Wierus/CountryClock/Data/Photo/WorkMode - ShowTemperature - No sensor.JPG

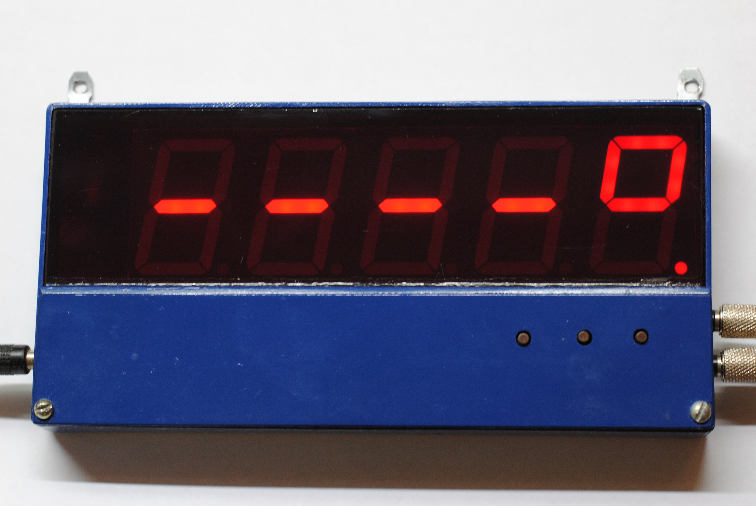
Data/Photo/WorkMode - ShowTemperature - No sensor.JPG
