Wierus/CountryClock/Data/Photo/WorkMode - ShowTime.JPG

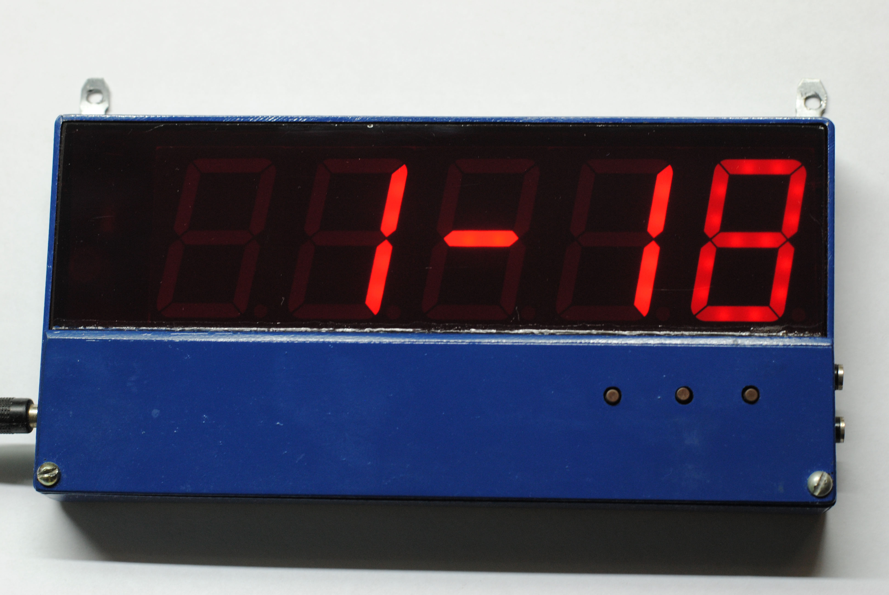
Data/Photo/WorkMode - ShowTime.JPG
