Wierus/CountryClock/Data/Tasks.pdf

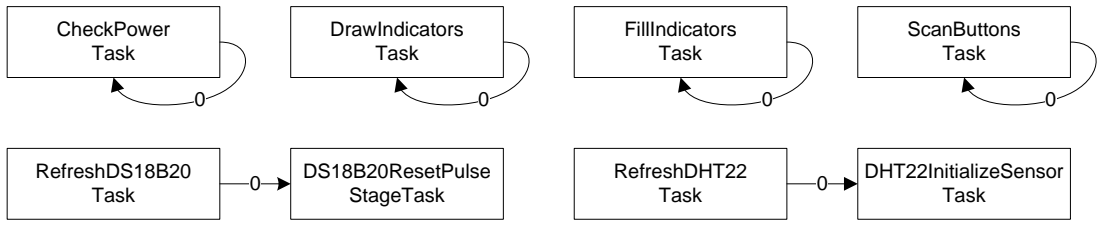
[picture p3: figure]
ScanButtons Task; DrawIndicators Task; FillIndicators Task; RefreshDHT22 Task; CheckPower Task; DS18B20ResetPulse StageTask; RefreshDS18B20; Task; DHT22InitializeSensor Task
