Wierus/CountryClock/Data/Photo/PCB Front.JPG

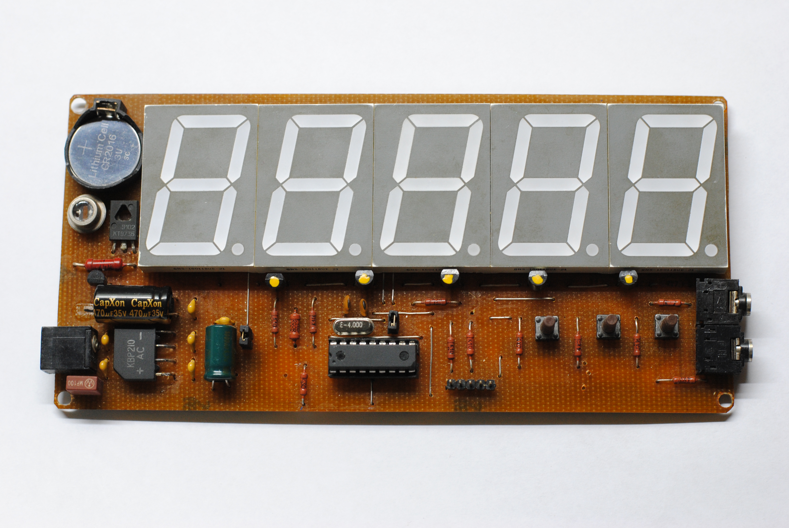
Data/Photo/PCB Front.JPG
