Wierus/CountryClock/Data/Photo/WorkMode - ShowHumidity.JPG

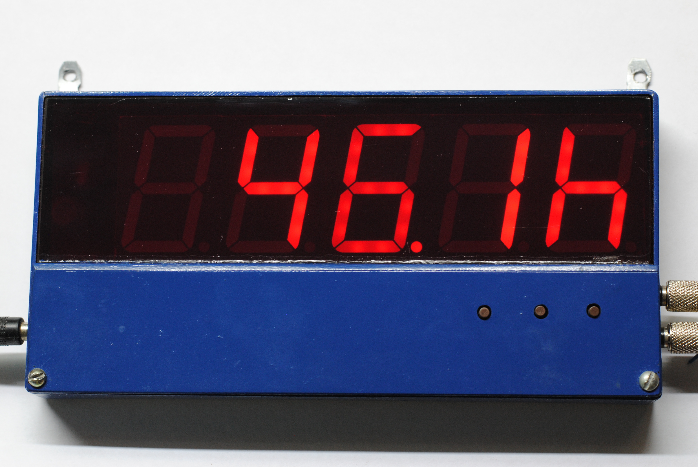
Data/Photo/WorkMode - ShowHumidity.JPG
