Wierus/CountryClock/Data/Photo/WorkMode - ShowTemperature.JPG

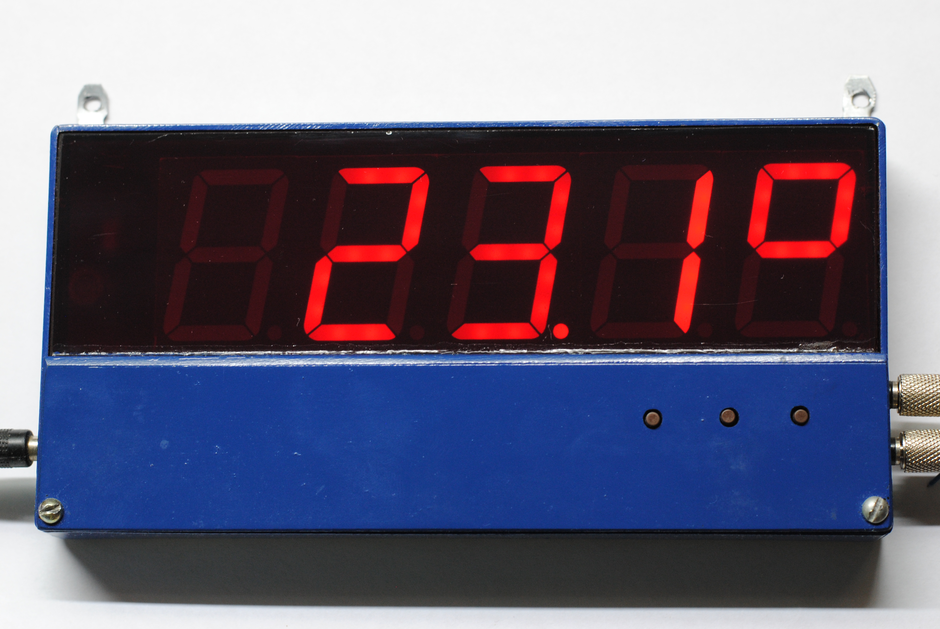
Data/Photo/WorkMode - ShowTemperature.JPG
