Wierus/CountryClock/Scheme/CountryClock (Build).PDF

## USTAB JPOWER

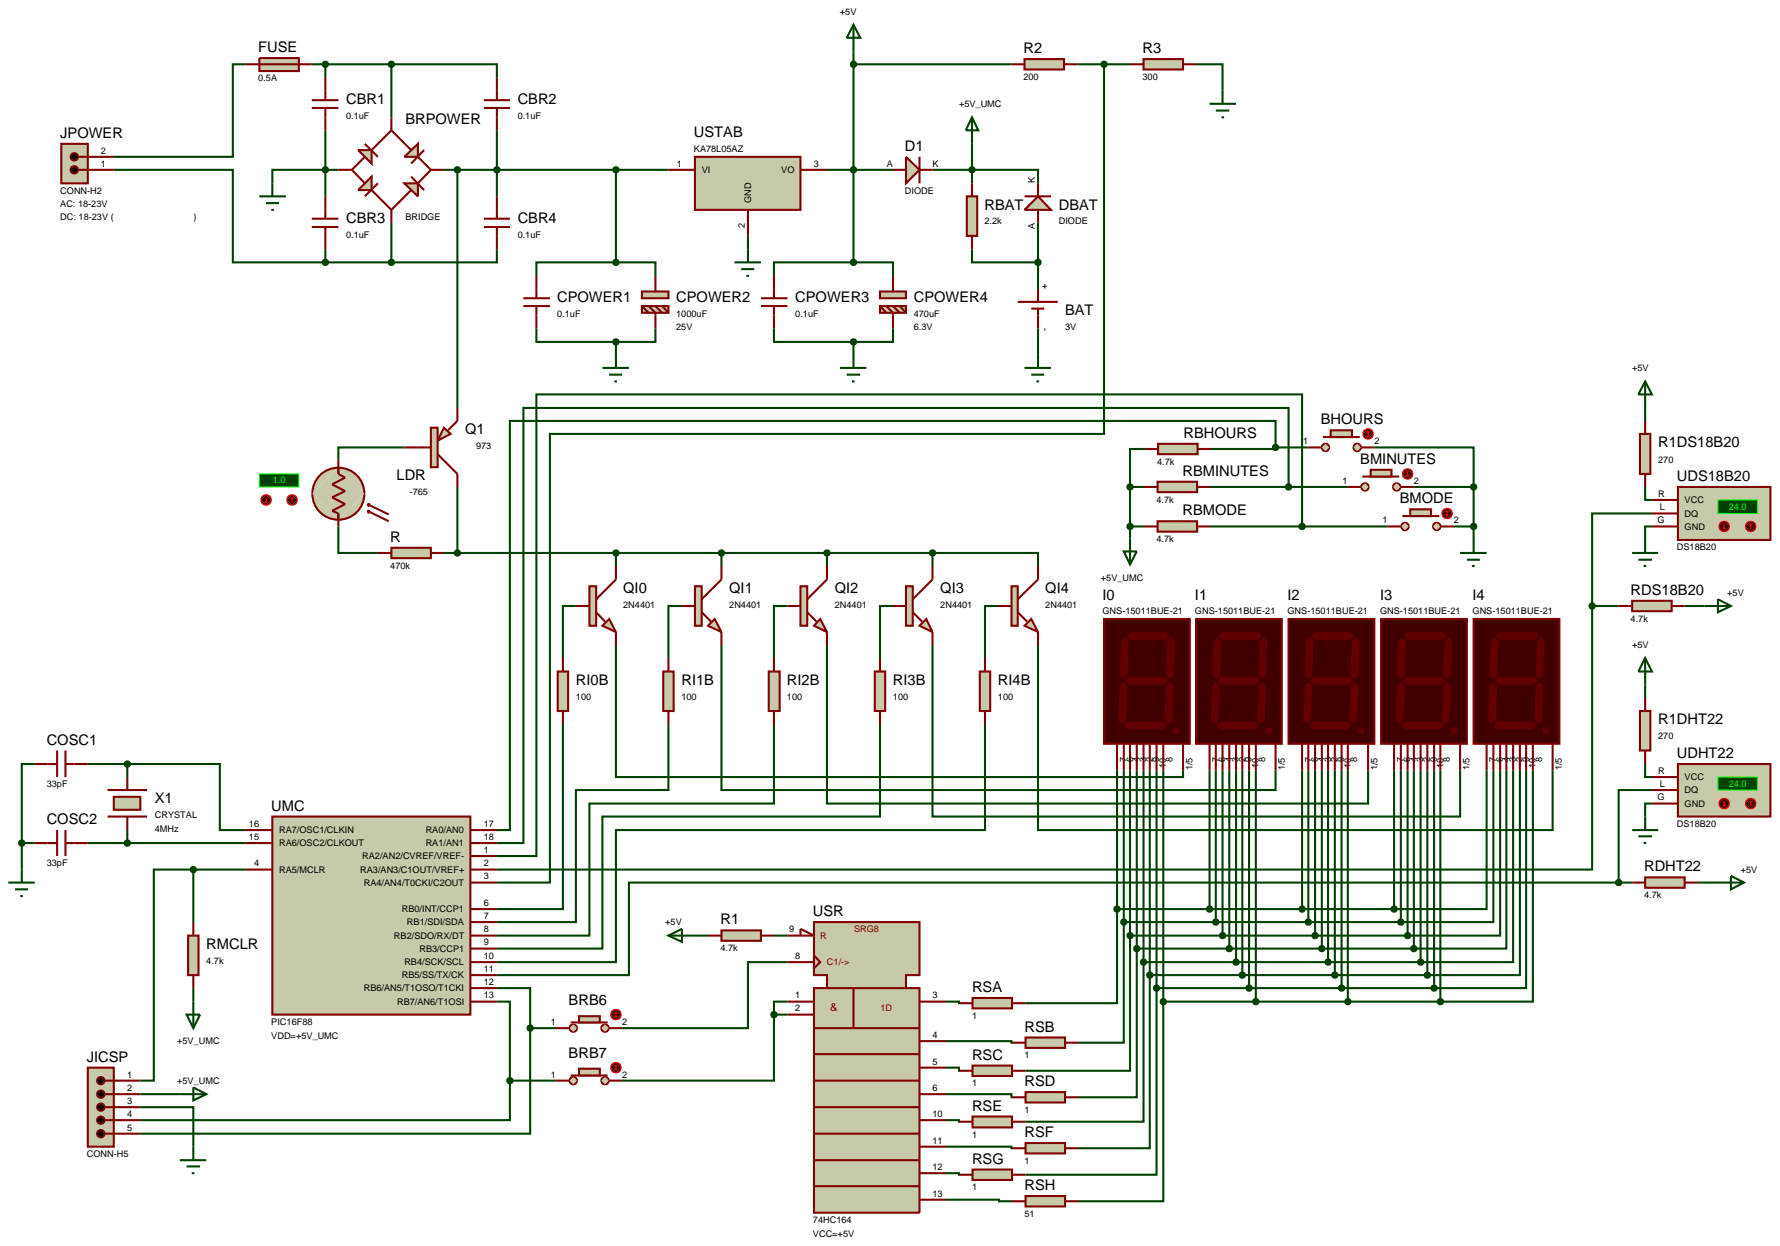
[picture p7: page 1]
RSA; RSB; RSC; RSD; RSE; RSF; RSG; GNS-15011BUE-21; RSH; SRG8; USR; 74HC164 VCC=+5V; CRYSTAL 4MHz; COSC1; COSC2; RMCLR; +5V_UMC; VCC R; GND G; UDS18B20; UDHT22; DS18B20 внешний; BHOURS; BMINUTES; BMODE; RBMINUTES; RBHOURS; RBMODE; GND; BRPOWER; BRIDGE; CPOWER1; CPOWER2; CPOWER3; CPOWER4; CBR1; CBR3; CBR2; CBR4; FUSE; R1DHT22; DIODE; DBAT; BAT; RBAT; JICSP; CONN-H5; BRB6; BRB7; LDR; RDS18B20; RA7/OSC1/CLKIN 16; RB0/INT/CCP1; RB1/SDI/SDA; RB2/SDO/RX/DT; RB3/CCP1; RB4/SCK/SCL; RB6/AN5/T1OSO/T1CKI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

CONN-H2
DC: 18-23V (любой полярности)
