Wierus/CountryClock/(list of files, drawings)

Other design files:
Scheme/CountryClock (Build).DSN
Scheme/CountryClock (Build).LYT
Scheme/CountryClock (Emulation).DSN
