Wierus/CountryClock/(commit log)

2016-01-11 Создан пустой проект для PIC16F88 в MPLAB X IDE v3.20
2016-01-20 Добавлен файл .gitignore
2016-01-20 Обновлен файл .gitignore
2016-01-20 Добавлена программа
2016-01-20 Добавлены схема и печатная плата
    [CountryClock (Build).DSN, CountryClock (Build).LYT, CountryClock (Emulation).DSN]
2016-01-20 Исправлена ошибка, при которой коррекция часов выполнялась в любом режиме
    Сейчас коррекция выполняется только в режиме отображения времени.
    [main.c]
2016-01-20 Мигание индикатора секунд изменено с частоты 0,5 Гц на частоту 1 Гц
2016-01-20 Для линковщика включен параметр "Create summary file"
2016-01-20 Обновлены схема и печатная плата
    [CountryClock (Build).DSN, CountryClock (Build).LYT]
2016-01-20 Добавлен PDF-файл схемы
2016-01-20 Добавлен граф задач
2016-01-20 Уменьшена длина очереди задач (по актуальному количеству задач)
2016-01-20 Исправлен файл конфигурации проекта
2016-01-20 Добавлены фотографии
2016-01-21 Обновлено имя страницы в файле Tasks.vsd
2016-02-07 Функции инициализации сделаны инлайновыми
2016-02-08 Подтяжка кнопок на схеме и на печатной плате перенесена на +5V от батареи для исключения нажатия кнопок при изменении питания "от батареи"/"от сети"
    [CountryClock (Build).DSN, CountryClock (Build).LYT]
2016-02-08 В схеме исправлены обозначения элементов для датчика DHT22
    [CountryClock (Build).DSN, CountryClock (Emulation).DSN]
2016-02-08 Обновлены библиотеки, обновлен граф задач
2016-02-23 Обновлены библиотеки, работа с датчиком DS18B20 переведена на асинхронный режим
2016-02-23 В схеме эмуляции для датчика DS18B20 значение свойства "Time Reset Low" установлено в "5ms"
    [CountryClock (Emulation).DSN]
2016-02-27 Обновлены библиотеки
2016-02-27 Обновлены библиотеки DS18B20Tasks и DS18B20Async
2016-02-27 Обновлены библиотеки DS18B20 и DS18B20Async
